lukaso25/aardvark-q10-reverse-engineering/aardvark pinout.ods

Aardvark Direct Pro Q10 External module DB-25 pinout
DB-25 pin | direction | description | modification for future use
1 | to aardvark | PIC 18 | SCL
2 | from aardvark | from PLD | SCLK
3 |  | GND
4 | to aardvark | AKM_DAC_4
5 |  | +5 V digital
6 | to aardvark | AKM_DAC_1
7 | from aardvark | SPDIF_RECV
8 | from aardvark | AKM_ADC_3
9 | from aardvark | AKM_ADC_2
10 |  | -12 V analog
11 |  | GND
12 |  | +12 V analog
13 | to aardvark | MIDI_TRANS
14 |  | +5 V digital
15 | from aardvark | from PLD | LRCLK
16 | to aardvark | CS4340_DAC
17 | to aardvark | AKM_DAC_3
18 | to aardvark | AKM_DAC_2
19 |  | GND
20 | from aardvark | AKM_ADC_4
21 |  | +5 V digital
22 | from aardvark | AKM_ADC_1
23 |  | GND
24 | bidirectional | PIC – buffered | SDA
25 | from aardvark | MIDI_RECV
