lukaso25/aardvark-q10-reverse-engineering/pinout.png

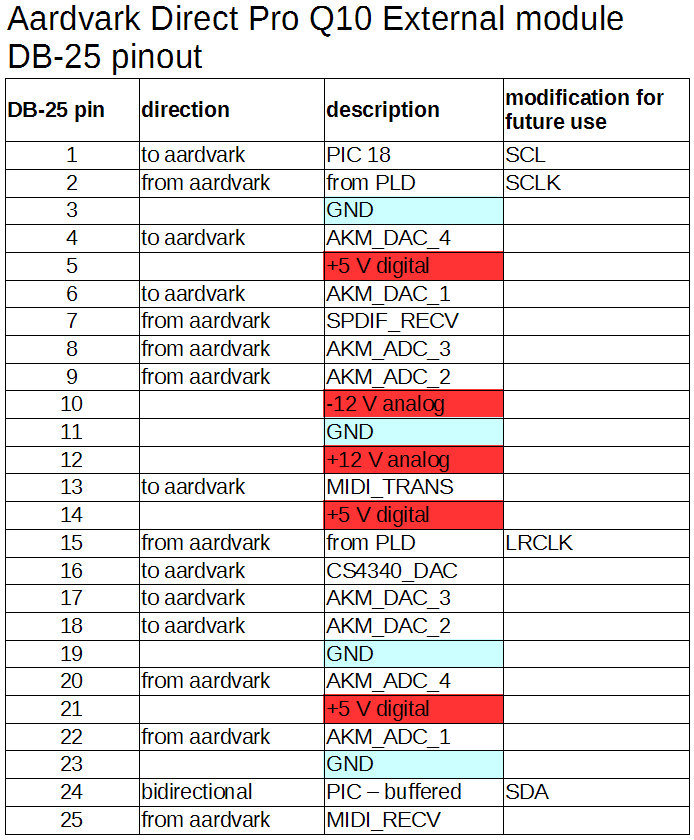
pinout.png
