lukaso25/aardvark-q10-reverse-engineering/avr-hardware/aard-mod.pdf

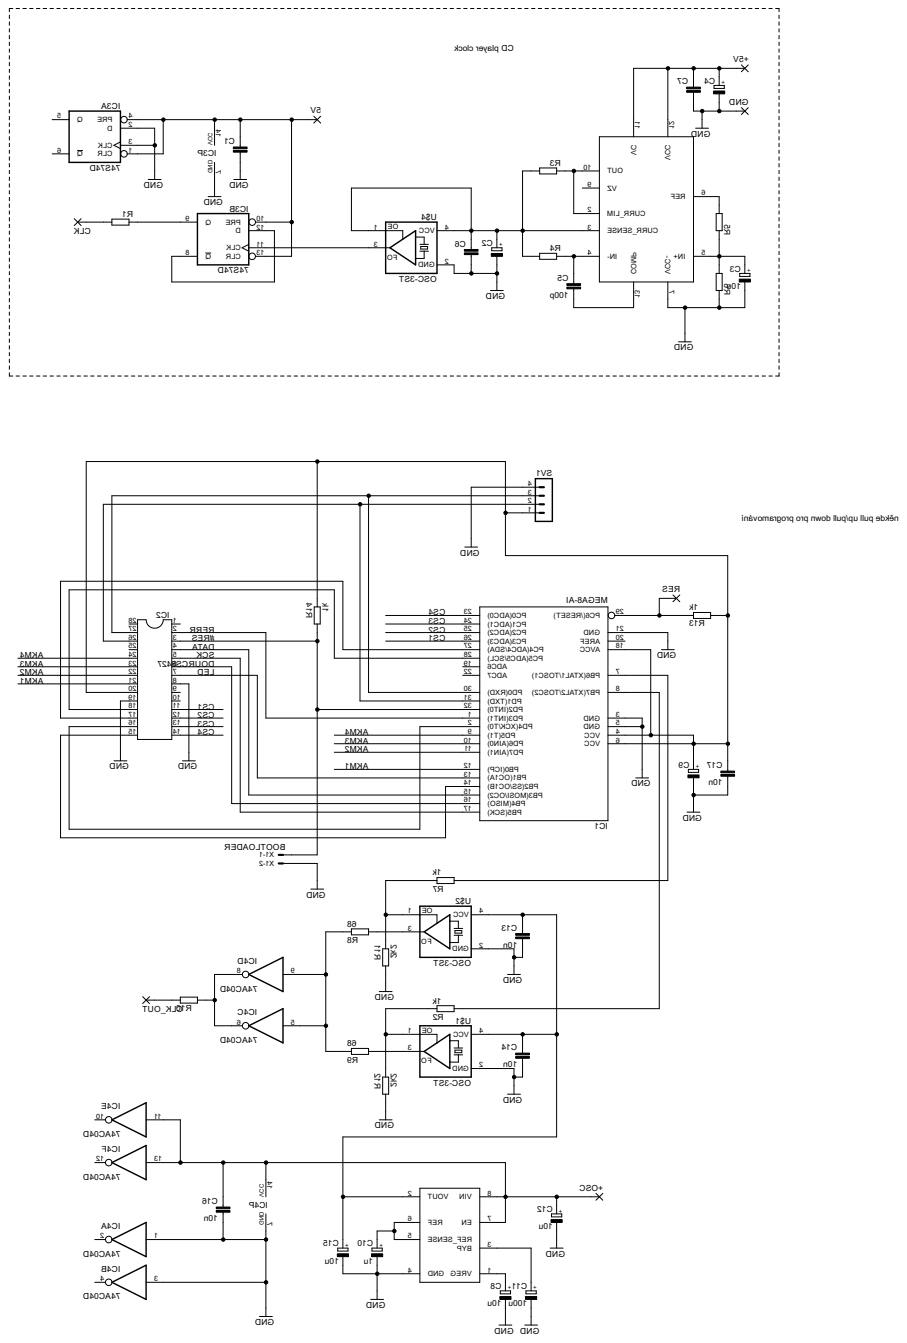
[picture p2: page 1]

kcol cr eyal p DC

í návo mar gor p or p nwodll up/ pull up edkěn

E4 CI 01 11 F4 CI 21 31 P4 CI GND VCC
