lukaso25/aardvark-q10-reverse-engineering/avr-hardware/aard-mod.brd

## EAGLE design avr-hardware/aard-mod.brd (2015-03-29)

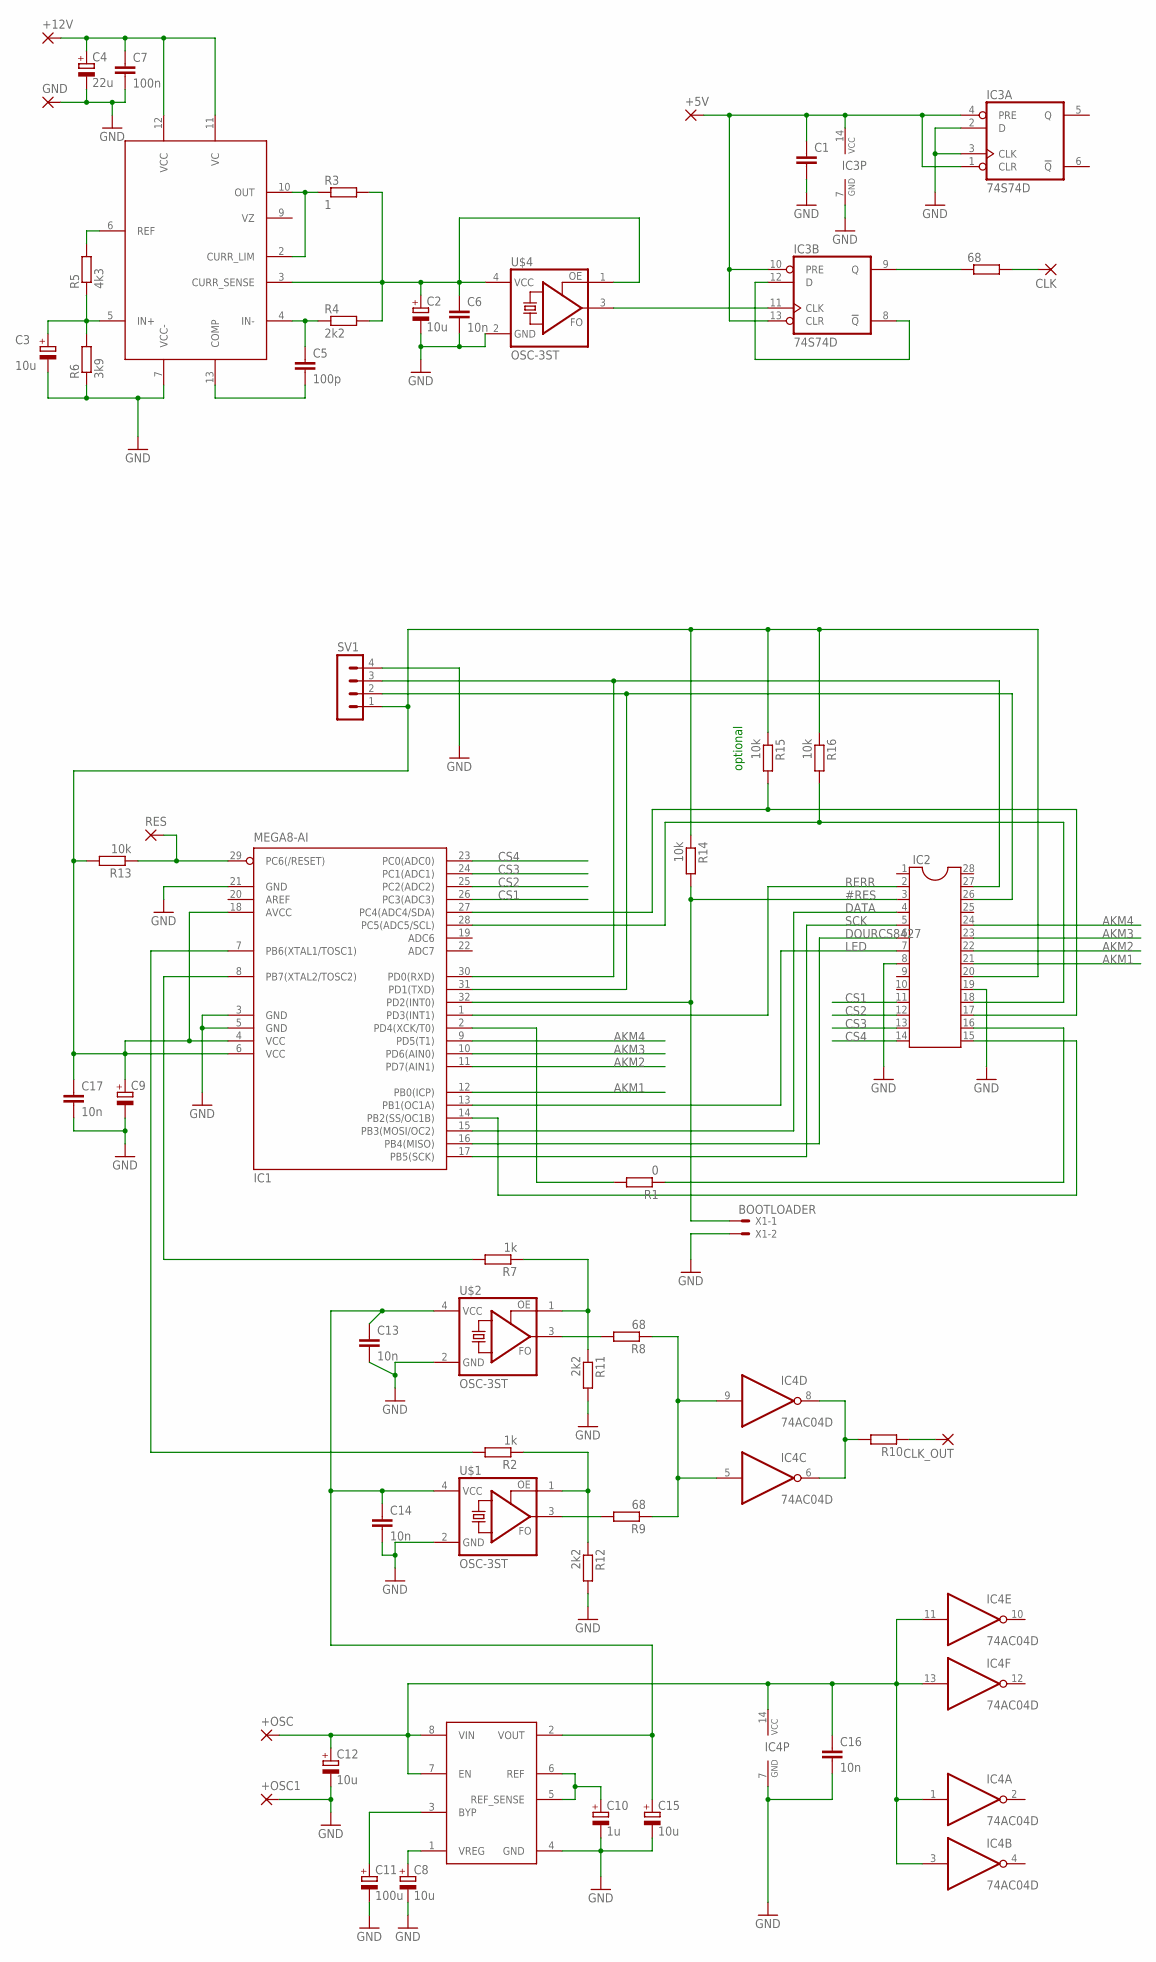
[picture p3: schematic aard-mod.sch]

Parts:
68: R-EU_M1206; M1206
+5V, +12V: 2,54/1,0
+OSC, +OSC1: 2,54/1,0
C1: C-EUC1206K; C1206K
C2, C8, C15: 10u; SMC_B
C3, C12: 10u; SMC_D
C4: 22u; SMC_D
C5: 100p; C0805K
C6, C17: 10n; C0805K
C7: 100n; C1206K
C9: CPOL-EUSMCB; SMC_B
C10: 1u; SMC_B
C11: 100u; SMC_D
C13, C14, C16: 10n; C1206
CLK: 2,54/1,0
CLK_OUT: 2,54/1,0
GND: 2,54/1,0
IC1: MEGA8-AI; TQFP32-08
IC2: DIL28-3
IC3: 74S74D; SO14
IC4: 74AC04D; SO14
R1: 0; R1206
R2, R7: 1k; R1206
R3: 1; M1206
R4, R11, R12: 2k2; R0805
R5: 4k3; R0805
R6: 3k9; R0805
R8, R9: 68; R1206
R10: R-EU_R0805; R0805
R13, R14, R15, R16: 10k; R1206
RES: 2,54/1,0
SV1: MA04-1
U$1, U$2, U$4: OSC-3ST; OSC2X2.5
U$3: 723; SO14
U$5: ADM7150; SO8-COOL
X1: BOOTLOADER; 22-23-2021

Connections:
5V: +12V.1, C4.+, C7.1, U$3.11 (VC), U$3.12 (VCC)
#RES: IC1.32 (PD2(INT0)), IC2.3, R14.2, X1.1
AKM1: IC1.12 (PB0(ICP)), IC2.21
AKM2: IC1.11 (PD7(AIN1)), IC2.22
AKM3: IC1.10 (PD6(AIN0)), IC2.23
AKM4: IC1.9 (PD5(T1)), IC2.24
CS1: IC1.26 (PC3(ADC3)), IC2.11
CS2: IC1.25 (PC2(ADC2)), IC2.12
CS3: IC1.24 (PC1(ADC1)), IC2.13
CS4: IC1.23 (PC0(ADC0)), IC2.14
DATA: IC1.15 (PB3(MOSI/OC2)), IC2.4
DOURCS8427: IC1.16 (PB4(MISO)), IC2.6
GND: +OSC1.1, C1.2, C2.-, C3.-, C4.-, C6.2, C7.2, C8.-, C9.-, C10.-, C11.-, C12.-, C13.2, C14.2, C15.-, C16.2, C17.2, GND.1, IC1.3 (GND), IC1.5 (GND), IC1.21 (GND), IC2.8, IC2.19, IC3.2 (D), IC3.3 (CLK), IC3.7 (GND), IC4.7 (GND), R6.1, R11.2, R12.2, SV1.4, U$1.2 (GND), U$2.2 (GND), U$3.7 (VCC-), U$4.2 (GND), U$5.4 (GND), X1.2
LED: IC1.13 (PB1(OC1A)), IC2.7
unnamed: IC1.2 (PD4(XCK/T0)), R1.2
unnamed: IC1.14 (PB2(SS/OC1B)), IC2.15
unnamed: IC1.28 (PC5(ADC5/SCL)), IC2.18, R16.2
unnamed: IC1.27 (PC4(ADC4/SDA)), IC2.17, R15.2
unnamed: IC1.30 (PD0(RXD)), IC2.27, SV1.3
unnamed: IC1.8 (PB7(XTAL2/TOSC2)), R7.2
unnamed: IC1.31 (PD1(TXD)), IC2.26, SV1.2
unnamed: IC2.16, R1.1
unnamed: IC1.7 (PB6(XTAL1/TOSC1)), R2.2
unnamed: C10.+, U$5.5 (REF_SENSE), U$5.6 (REF)
unnamed: C8.+, U$5.1 (VREG)
unnamed: C11.+, U$5.3 (BYP)
unnamed: +OSC.1, C12.+, C16.1, IC4.1 (I), IC4.3 (I), IC4.11 (I), IC4.13 (I), IC4.14 (VCC), U$5.7 (EN), U$5.8 (VIN)
unnamed: C13.1, C14.1, C15.+, U$1.4 (VCC), U$2.4 (VCC), U$5.2 (VOUT)
unnamed: C9.+, C17.1, IC1.4 (VCC), IC1.6 (VCC), IC1.18 (AVCC), IC2.20, R13.2, R14.1, R15.1, R16.1, SV1.1
unnamed: IC3.8 (!Q), IC3.12 (D)
unnamed: IC3.11 (CLK), U$4.3 (FO)
unnamed: +5V.1, C1.1, IC3.1 (CLR), IC3.4 (PRE), IC3.10 (PRE), IC3.13 (CLR), IC3.14 (VCC)
unnamed: IC4.6 (O), IC4.8 (O), R10.2
unnamed: CLK_OUT.1, R10.1
unnamed: C5.2, U$3.13 (COMP)
unnamed: R3.1, U$3.2 (CURR_LIM), U$3.10 (OUT)
unnamed: C5.1, R4.1, U$3.4 (IN-)
unnamed: C2.+, C6.1, R3.2, R4.2, U$3.3 (CURR_SENSE), U$4.1 (OE), U$4.4 (VCC)
unnamed: R5.2, U$3.6 (REF)
unnamed: C3.+, R5.1, R6.2, U$3.5 (IN+)
unnamed: R8.2, U$2.3 (FO)
unnamed: R7.1, R11.1, U$2.1 (OE)
unnamed: R2.1, R12.1, U$1.1 (OE)
unnamed: 68.2, CLK.1
unnamed: R9.2, U$1.3 (FO)
unnamed: IC4.5 (I), IC4.9 (I), R8.1, R9.1
unnamed: IC1.29 (PC6(/RESET)), R13.1, RES.1
unnamed: 68.1, IC3.9 (Q)
RERR: IC1.1 (PD3(INT1)), IC2.2
SCK: IC1.17 (PB5(SCK)), IC2.5

Notes on the sheet:
optional

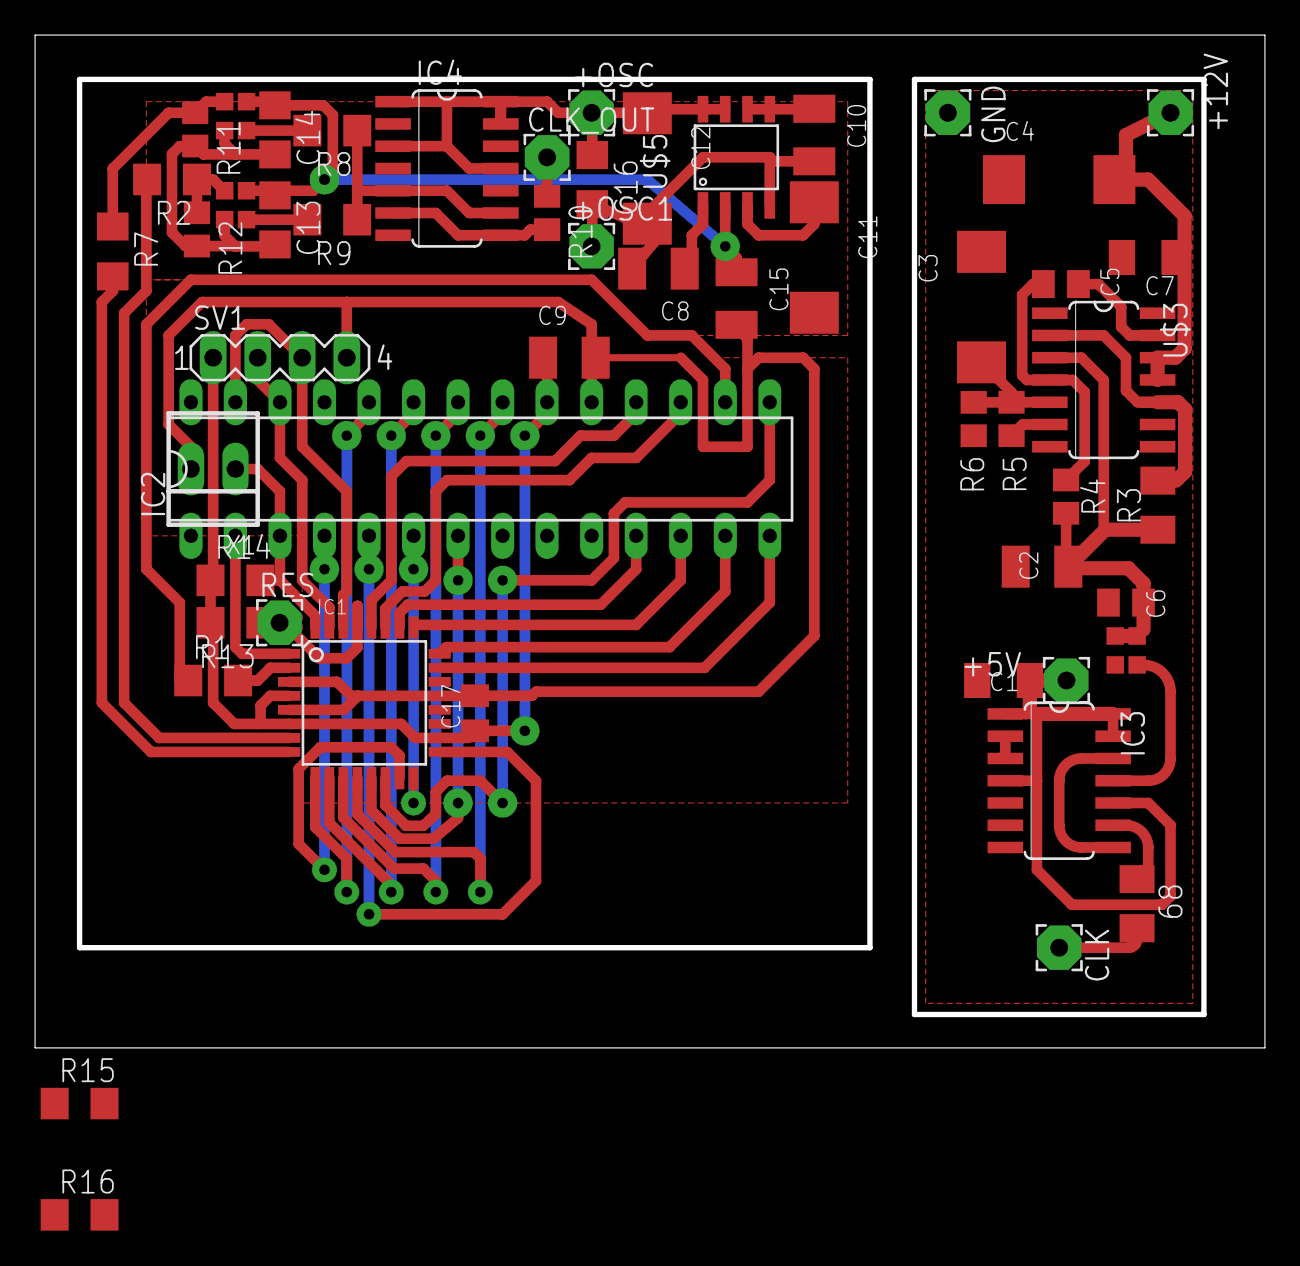
[picture p4: board aard-mod.brd from above]

Board: 2 copper layers, 70.2 x 57.8 mm, 53 parts (0 on the bottom side), 50 nets.
