lukaso25/aardvark-q10-reverse-engineering/(commit log)

2014-07-11 external module pinout
    [aardvark pinout.ods]
2015-03-29 PCB design - AVR mod board
    Eagle source files for modification PCB. This PCB substitutes
    functionality of original PIC microcontroller. PCB contains also low
    jitter clock oscilators.
    [aard-mod.brd, aard-mod.sch]
2015-03-29 code for AVR microcontroller added
    I2C slave device, only testing code with lot of debugging sections,
    skeleton of Ardvark hardware initialization and configuration
2016-02-03 changes in code, debug LCD, test program for littewire usb i2c interface
